r3dfx080/VHSDecode-HSDAOH-Capture-Hardware-Development/initial_setup_and_modification/assets/original-schematic.jpg

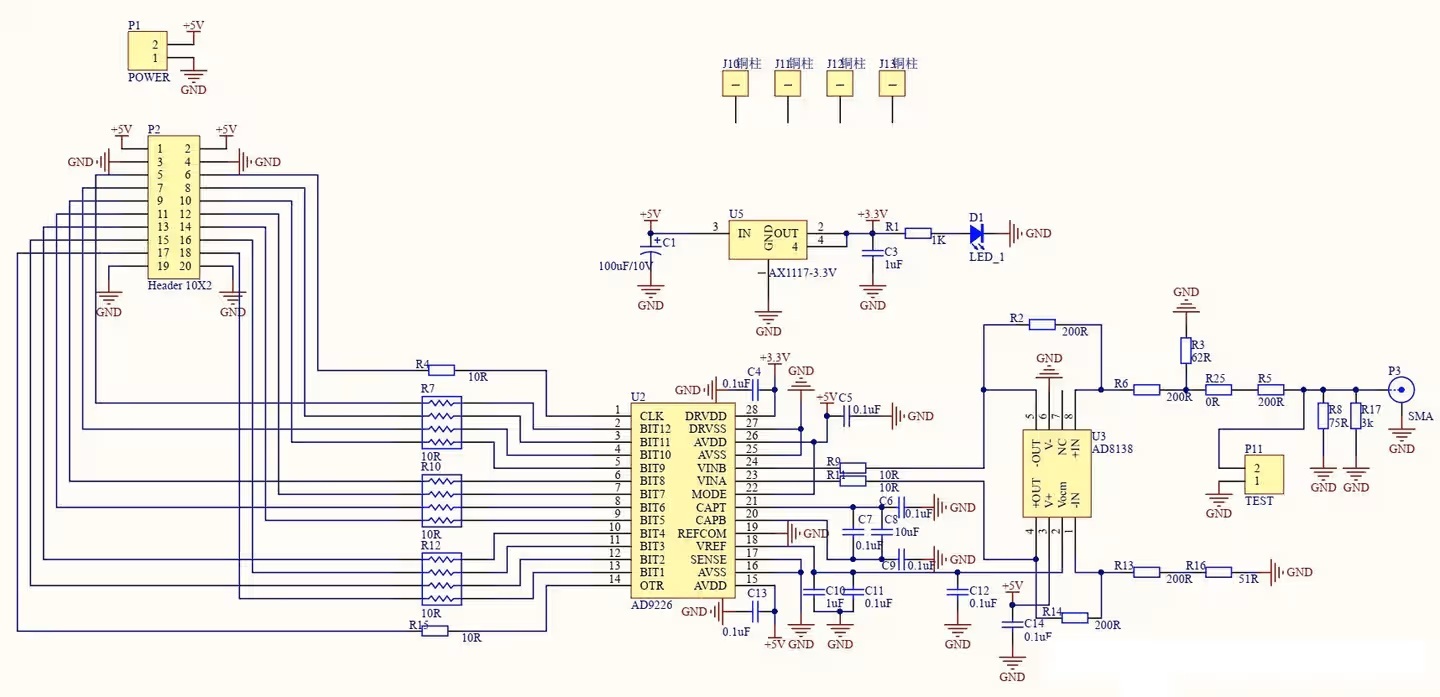
initial_setup_and_modification/assets/original-schematic.jpg
