r3dfx080/VHSDecode-HSDAOH-Capture-Hardware-Development/initial_setup_and_modification/assets/schematic-gain-mod.JPG

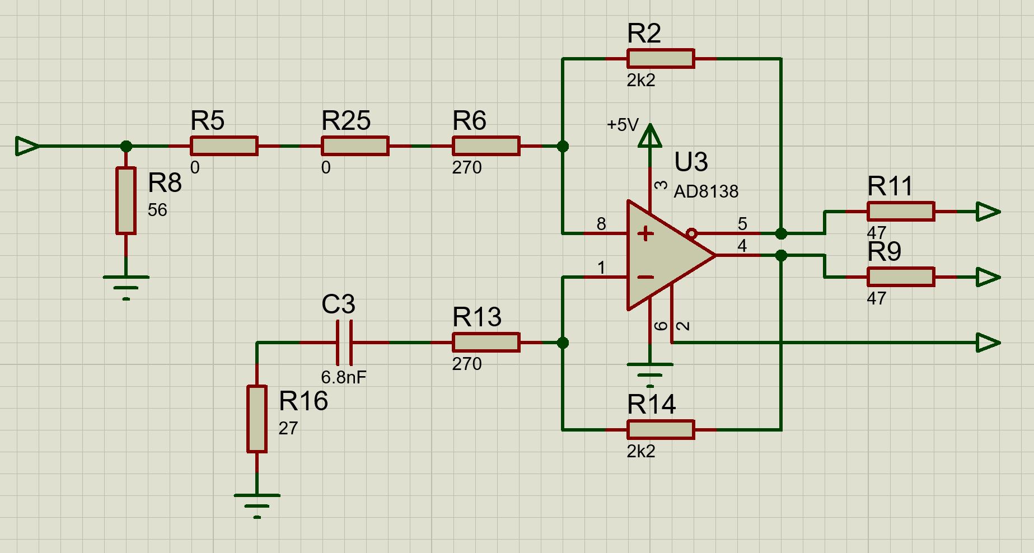
initial_setup_and_modification/assets/schematic-gain-mod.JPG
