r3dfx080/VHSDecode-HSDAOH-Capture-Hardware-Development/(list of files, drawings)

Other design files:
initial_setup_and_modification/assets/gain-lpf-mod.pdsprj
initial_setup_and_modification/assets/gain-mod.pdsprj
initial_setup_and_modification/assets/stock.pdsprj
