r3dfx080/VHSDecode-HSDAOH-Capture-Hardware-Development/initial_setup_and_modification/assets/AD9226-Module-AD8138-R02-LTSpice.jpg

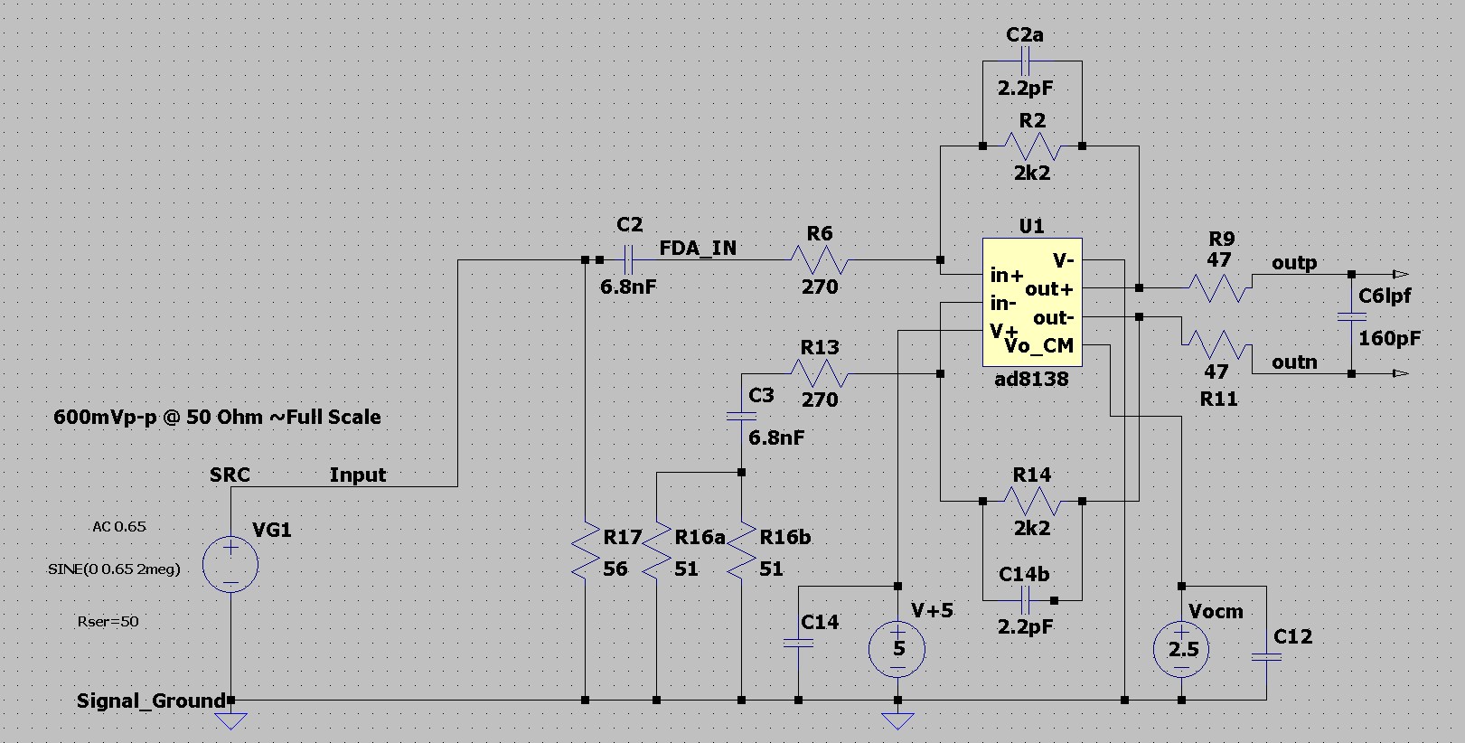
initial_setup_and_modification/assets/AD9226-Module-AD8138-R02-LTSpice.jpg
