r3dfx080/VHSDecode-HSDAOH-Capture-Hardware-Development/(commit log)

2026-06-07 Kicad AD9226 Module AD8138 Opamp improvement R02
    Source Schematic with markup - R02 - 06.06.2026 - MA
2026-06-07 JPG of LTSpice Schematic
2026-06-11 hsdaoh-rp2350 external_adc - Pico 2 Firmware
    a187e84 - built from Nov 2025 for hsdaoh-rp2350
    external_adc - vhs-decode capture device firmware.
2026-06-13 Add stock board photo
2026-06-13 Rework setup & mod guide, improve main README
    [AD9226-analog-front-stock.pdsprj, gain-lpf-mod.pdsprj, gain-mod.pdsprj]
2026-06-13 Bump up readme version
    [stock.pdsprj]
2026-06-14 Fix incorrect schematics
    [gain-lpf-mod.pdsprj, gain-mod.pdsprj]
2026-06-14 Fix README resistance error
2026-06-14 Adjust BOM according to the latest changes
2026-06-17 Pico 2 clipping LED firmware
2026-07-04 Add early ADC clipping fix guide
2026-07-08 Update capacitor value for R25 in README
2026-07-08 Modify C3 capacitor value in README
    Updated capacitor value for C3 from 6.8nF to 12nF.
